ricaun/tcc_luiz_henrique_cassettari/README.md

# TCC - Luiz Henrique Cassettari

Meu trabalho de conclusão de curso desenvolvido e apresentado no final de 2011 onde me graduei em engenharia elétrica em 2012/2.

## PROPOSTA DE EXPERIMENTO REMOTO DIDÁTICO APLICADO AO CONTROLE DE ROTAÇÃO DE MOTOR DE CORRENTE CONTINUA 

O projeto tinha como objetivo controlar a velocidade de um motor de corrente continua pela internet, permitindo controlar os paramentos do PID (proporcional, integral e derivativo) utilizando um Applet que fazia a conexão do experimento remoto e o usuário.

Pena que o projeto não esta mais em funcionamento na faculdade, segue o vídeo de como era o funcionamento.

[](https://youtu.be/AxsXSH3sNRo)

## Arquivos

* <a href="TCC_LUIZ_HENRIQUE_CASSETTARI.pdf" target="_blank">TCC</a> 
* <a href="TCC_LHC_Apresentação.pdf" target="_blank">Apresentação</a> 
* <a href="Code/Arduino" target="_blank">Code - Arduino</a> 
* <a href="Code/Java" target="_blank">Code - Applet</a>
