ricaun/tcc_luiz_henrique_cassettari/TCC_LHC_Apresentação.pdf

## PROPOSTA DE EXPERIMENTO REMOTO DIDÁTICO APLICADO AO CONTROLE DE ROTAÇÃO DE MOTOR DE CORRENTE CONTINUA

Acadêmico: Luiz Henrique Cassettari
Orientador: Prof. Me. João Mota Neto
Trabalho de Conclusão de Curso - Engenharia Elétrica - Dezembro de 2011

# Objetivos

# - Experimento Remoto

# - Ambiente de Aprendizagem

# - Controle PID

# - Motor CC

# Experimento Remoto

## Usuário

## Experimento

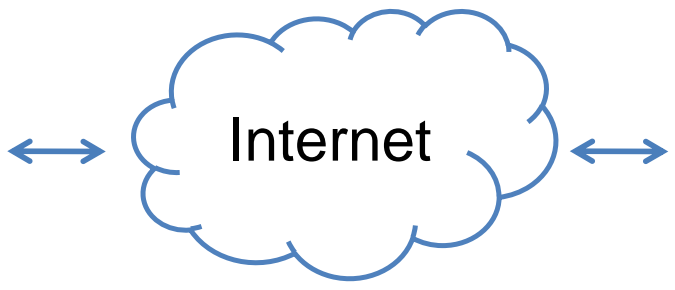
[picture p1: figure]
Internet
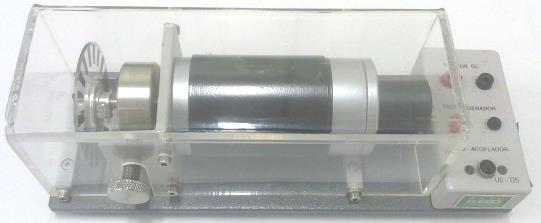
[picture p2: figure]

# Objeto Controlado

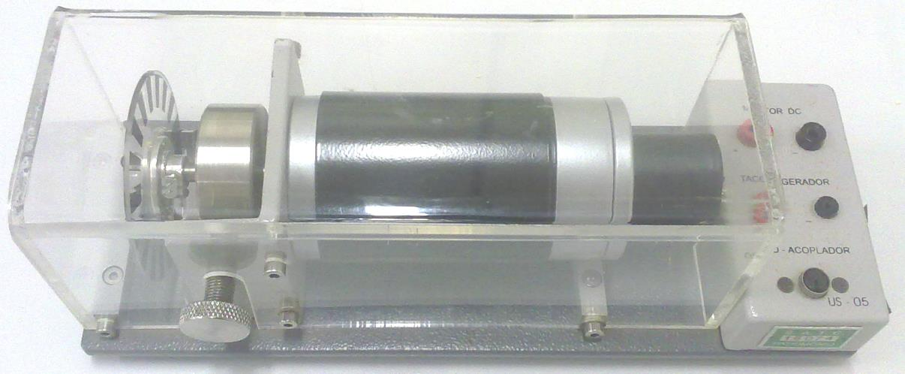
[picture p3: figure]

# - Tensão de Operação (24V)

# - Corrente Nominal (1A)

# - Tensão do Taco gerador (2V)

# Eletrônica Utilizada no Experimento

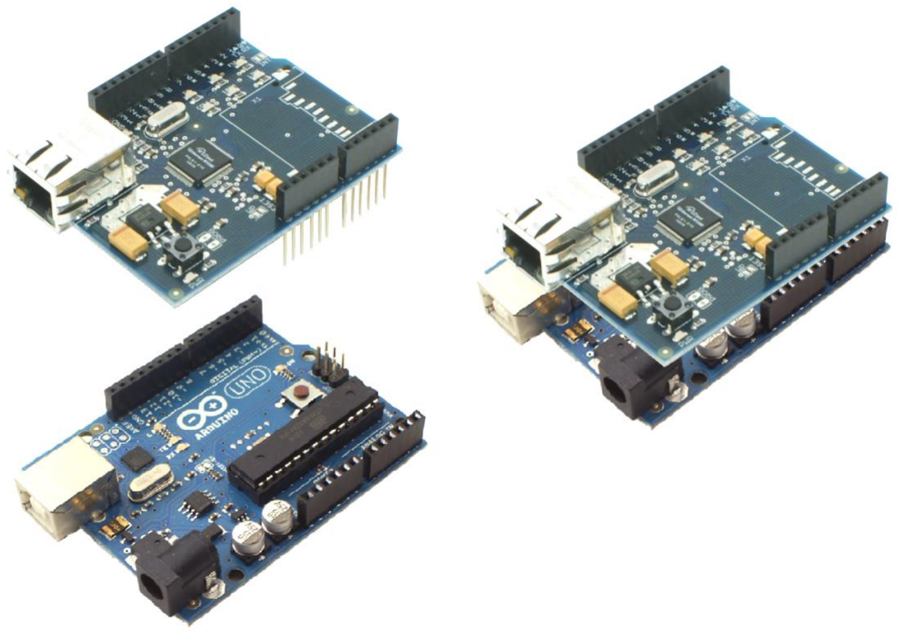
[picture p4: figure]

# - Arduino Uno

# - Ethernet Shield

# Placa Auxiliar

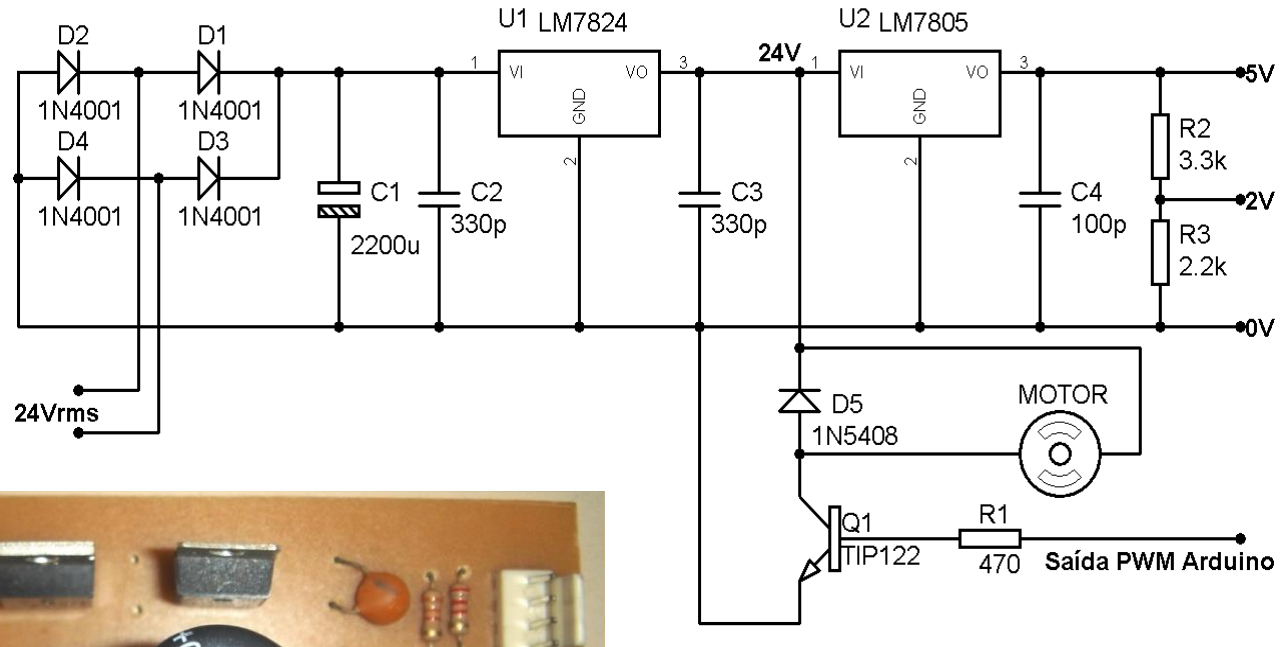
[picture p5: figure]

# Ambiente do Arduino

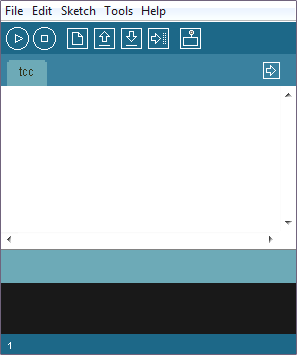
[picture p6: figure]

# Algoritmo PID

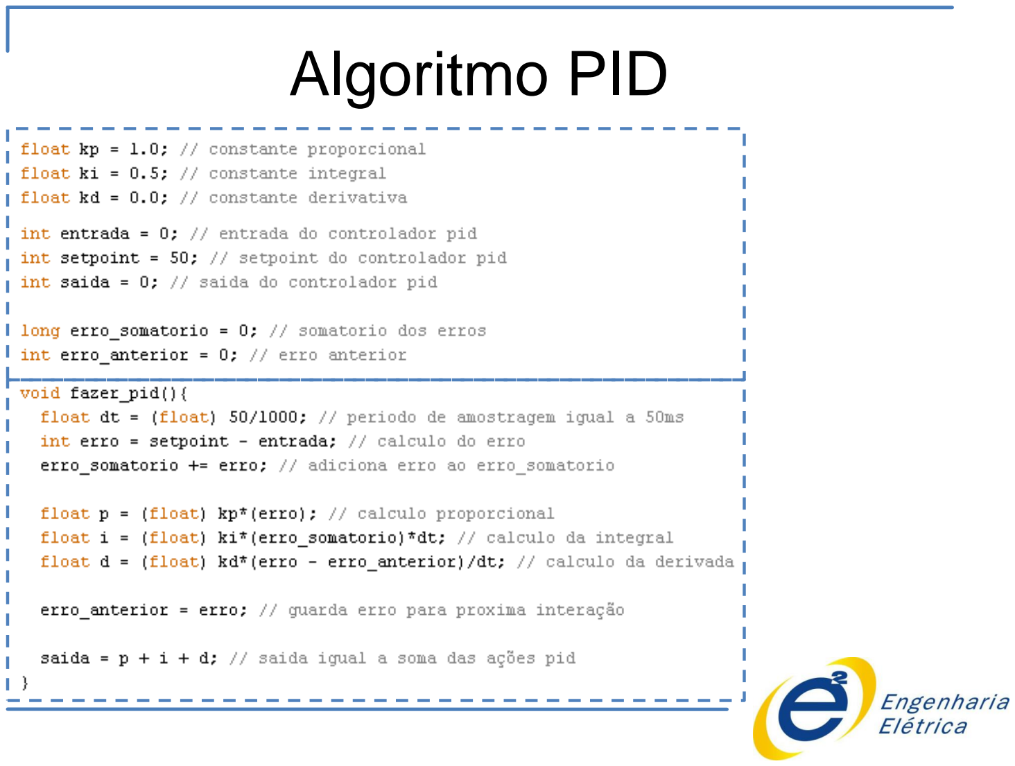
[picture p7: page 8]

# Fluxograma do Arduino

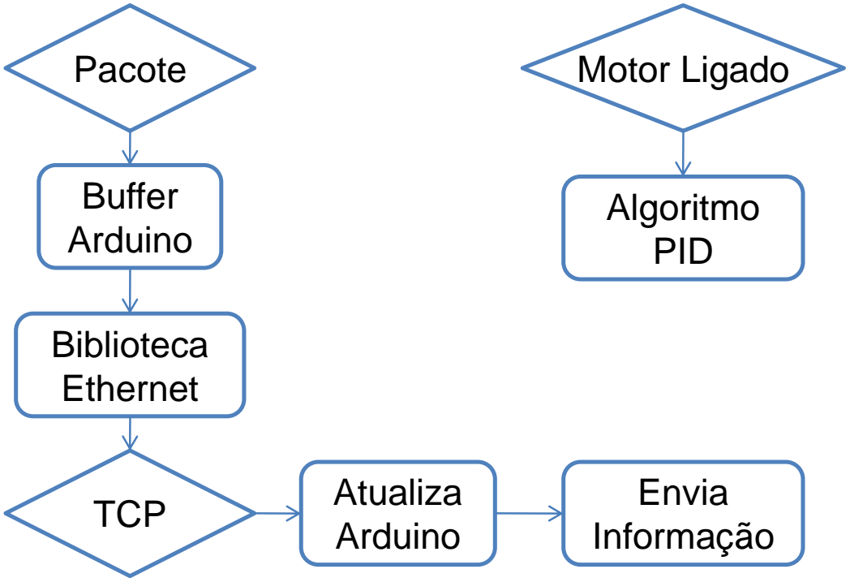
[picture p8: figure]
Pacote; Buffer Arduino; Biblioteca Ethernet; TCP; Atualiza; Arduino; Envia Informação; Motor Ligado; Algoritmo PID

# Ambiente do Usuário

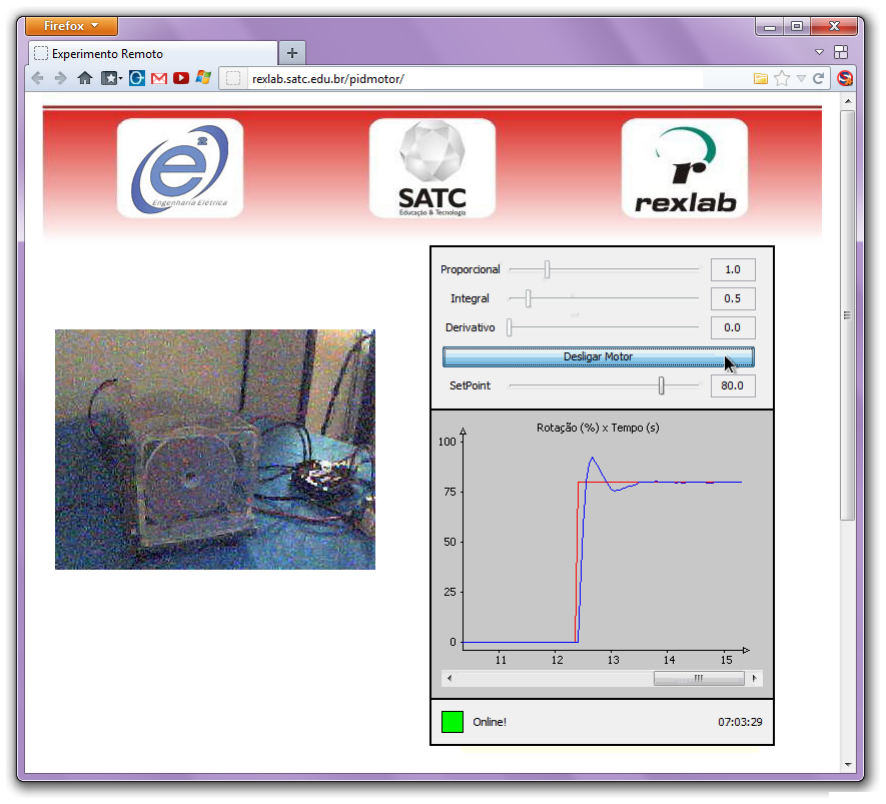
[picture p9: figure]

# Fluxograma do Applet

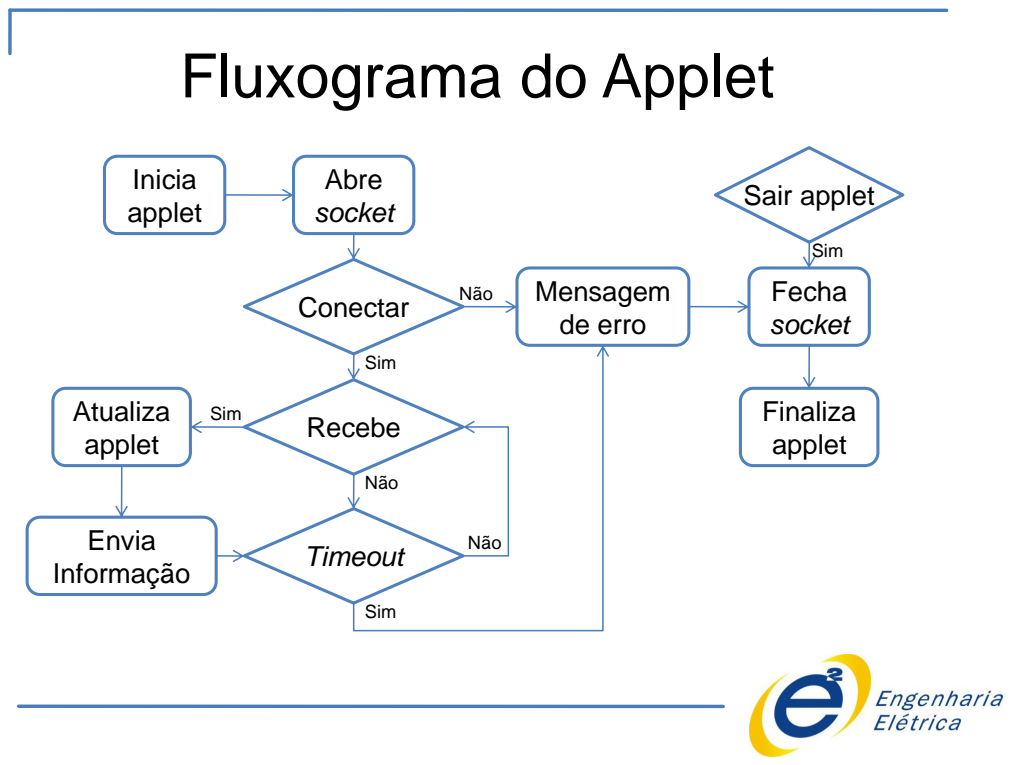
[picture p10: page 11]
Inicia applet; Abre socket; Conectar; Recebe Atualiza applet; Envia; Informação; Timeout; Mensagem de erro; Fecha socket; Finaliza applet; Sair applet; Sim; Não

# Validação do Algoritmo

75

60

# Simulações

Setpoint | | 60%
Controlador | Kp | Ki | Kd
P | 1.0
| 5.0
PI | 5.0 | 0.5
| 5.0 | 2.0

PID

5.0 | 0.5 | 0.5
5.0 | 2.0 | 0.5
5.0 | 0.5 | 2.0
5.0 | 2.0 | 2.0
Setpoint | | 80%
Controlador | Kp | Ki | Kd
P | 1.0
| 5.0
PI | 5.0 | 0.5
| 5.0 | 2.0

PID

5.0 | 0.5 | 0.5
5.0 | 2.0 | 0.5
5.0 | 0.5 | 2.0
5.0 | 2.0 | 2.0

# Comparação do Controlador P

60

51

0.51

0.6

Simulado no Matlab | Gráfico do Aplicativo

# Comparação do Controlador PI

60

0.6

Simulado no Matlab | Gráfico do Aplicativo

# Comparação do Controlador PID

60

0.6

Simulado no Matlab | Gráfico do Aplicativo

# Conclusão

# - Controle PID Motor

# - Validação do Algoritmo

# - Acessibilidade do Experimento

# Obrigado

## PROPOSTA DE EXPERIMENTO REMOTO DIDÁTICO APLICADO AO CONTROLE DE ROTAÇÃO DE MOTOR DE CORRENTE CONTINUA

Acadêmico: Luiz Henrique Cassettari
Orientador: Prof. Me. João Mota Neto
Trabalho de Conclusão de Curso - Engenharia Elétrica - Dezembro de 2011
